RJHFRS/Matrix-project/Documentation/Matrix Routing PCBV3.png

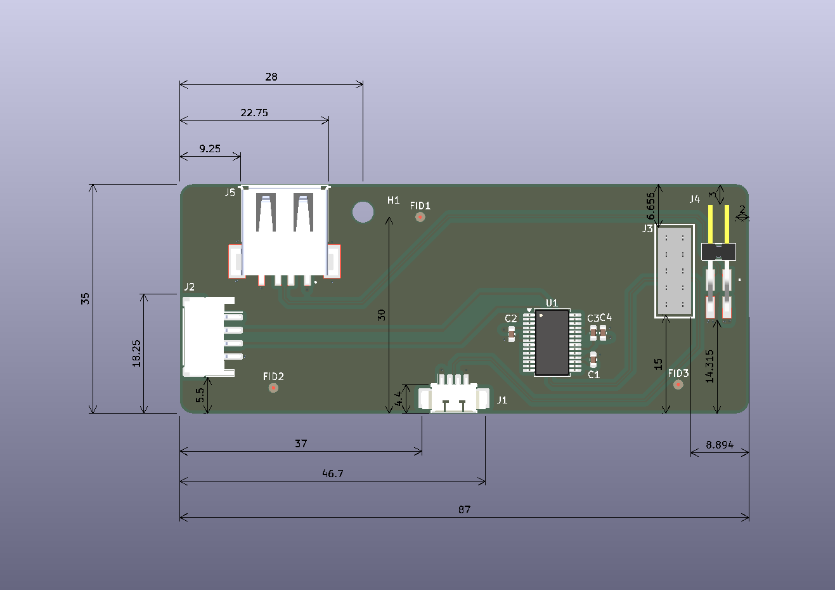
Documentation/Matrix Routing PCBV3.png
