RJHFRS/Matrix-project/Documentation/Matrix Routing PCB.png

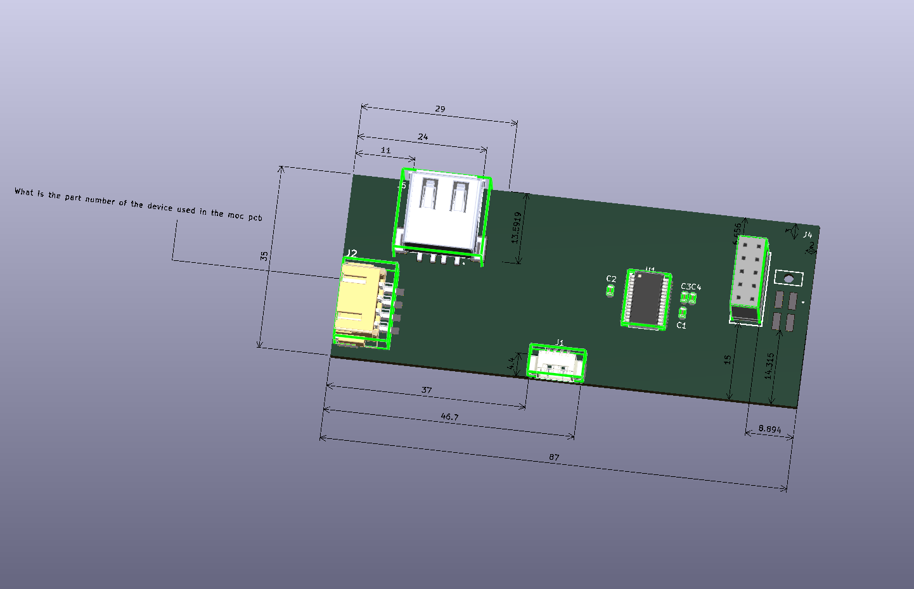
Documentation/Matrix Routing PCB.png
