RJHFRS/Matrix-project/Manufacturing/ASSEMBLY/MatrixMainBoard-Bom-OSpcb.ods

Designator | MPN | Qty | Description
C1, C3 | C0603C104K4RACTU | 2 | 0.1 µF ±10% 16V Ceramic Capacitor X7R 0603 (1608 Metric)
C2 | C0603C103K5RACTU | 1 | 10000 pF ±10% 50V Ceramic Capacitor X7R 0603 (1608 Metric)
C4 | GRM188C71C475KE21D | 1 | 4.7 µF ±10% 16V Ceramic Capacitor X7S 0603 (1608 Metric)
J1 | 53261-0471 | 1 | Connector Header Surface Mount, Right Angle 4 position 0.049" (1.25mm)
J2 | S4B-PH-SM4-TB | 1 | Connector Header Surface Mount, Right Angle 4 position 0.079" (2.00mm)
J3 | ESQ-105-23-T-D | 1 | 10 Position Elevated Socket Connector 0.100" (2.54mm) Through Hole Tin
J4 | TSM-102-01-L-DH-A | 1 | Connector Header Surface Mount, Right Angle 4 position 0.100" (2.54mm)
J5 | USB-A-S-F-B-SM2-R-TR | 1 | USB-A (USB TYPE-A) USB 2.0 Receptacle Connector 4 Position Surface Mount, Right Angle; Through Hole
U1 | FT232RL | 1 | IC USB FS SERIAL UART 28-SSOP
