RJHFRS/Matrix-project/Documentation/FullAssambly.FCStd

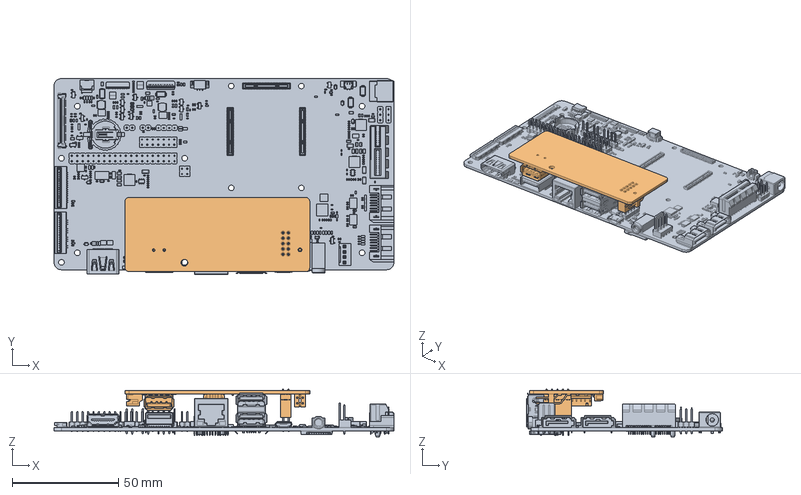
[picture p3: CAD file, 2026-09-24]
Documentation/FullAssambly.FCStd
160.0 x 92.2 x 22.6 mm
radxa_cm3_io_board_v1360_3d
Matrix Routing PCB_V3
