RJHFRS/Matrix-project/Documentation/FullAssamblyV2.FCStd

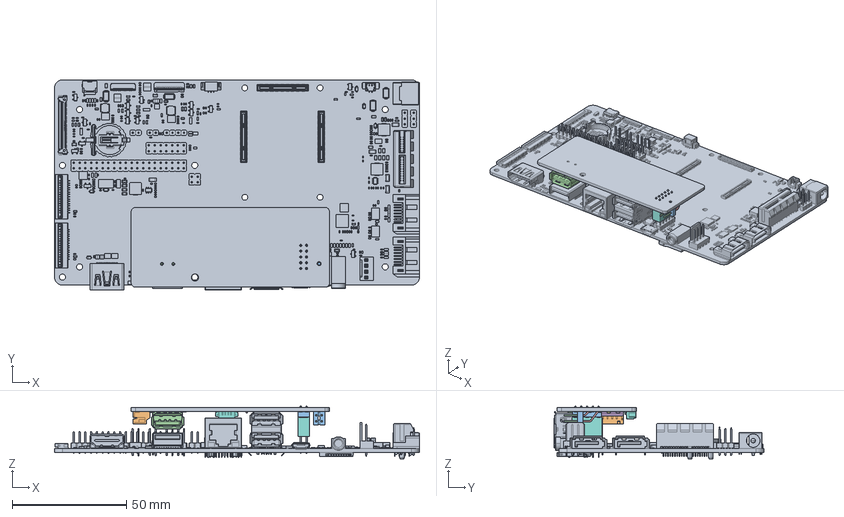
[picture p4: CAD file, 2026-09-24]
Documentation/FullAssamblyV2.FCStd
160.0 x 92.2 x 23.2 mm
Pcb_ed3
S4B-PH-SM4-TB part
TSM-102-01-DH-A_body
T-1S6-09-L(-01-2-DH)
T-1S6-09-L(-01-2-DH)2
C1_C_0603_1608Metric_a031bac950d4
C4_C_0603_1608Metric_6f453edf9163
ESQ-105-12-T-D_socket
ESQ-105-12-T-D_pins
ESQ-105-12-T-D2_pins
ESQ-105-12-G-D-LL_bpins
J5_USB-A-S-F-B-SM2-R-TR_759aa52d7a79
C2_C_0603_1608Metric_bcd04d63f79d
U1_SSOP-28_5.3x10.2mm_P0.65mm_af1eaf93d4b7
C3_C_0603_1608Metric_4dd471cfb941
J1_Molex_53261_0471_acc3970658d8
radxa_cm3_io_board_v1360_3d
