RJHFRS/Matrix-project/Documentation/Matrix Routing PCB_V3.step

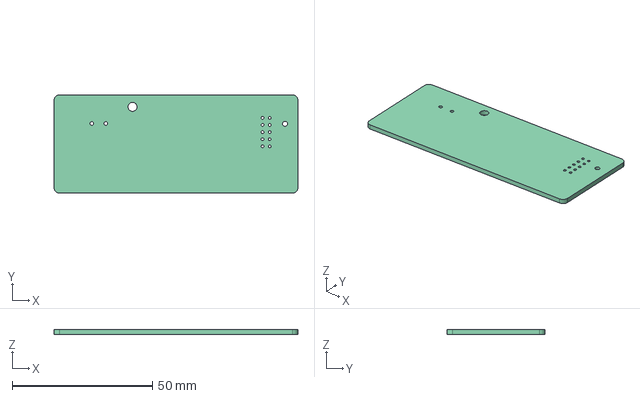
[picture p5: CAD file, 2026-09-24]
Documentation/Matrix Routing PCB_V3.step
87.0 x 35.0 x 1.66 mm
