RJHFRS/Matrix-project/MCAD/Matrix Routing PCBV8.FCStd

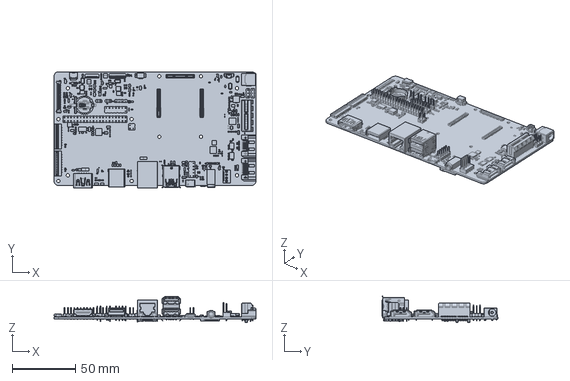
[picture p6: CAD file, 2026-10-01]
MCAD/Matrix Routing PCBV8.FCStd
160.0 x 92.2 x 20.8 mm
