RJHFRS/Matrix-project/MCAD/Matrix Routing PCBV7.FCStd

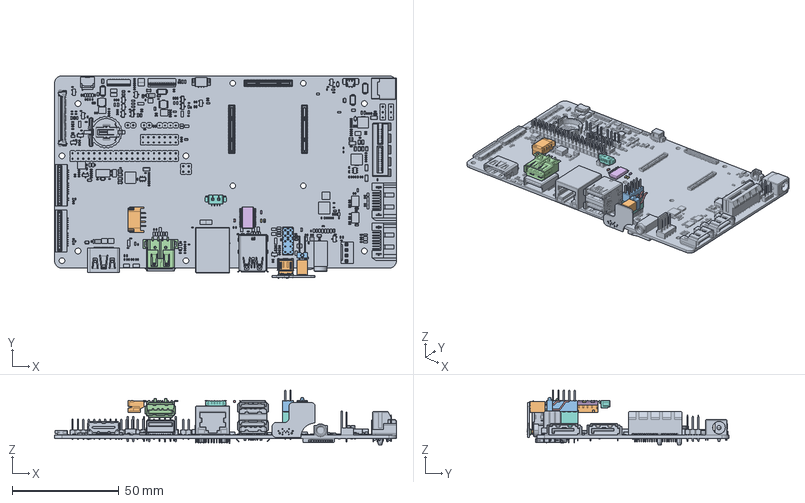
[picture p8: CAD file, 2026-09-28]
MCAD/Matrix Routing PCBV7.FCStd
160.0 x 94.7 x 25.5 mm
radxa_cm3_io_board_v1360_3d
S4B-PH-SM4-TB part
TSM-102-01-DH-A_body
T-1S6-09-L(-01-2-DH)
T-1S6-09-L(-01-2-DH)2
C1_C_0603_1608Metric_a031bac950d4
C4_C_0603_1608Metric_6f453edf9163
ESQ-105-23-T-D_socket
ESQ-105-23-T-D_pins
ESQ-105-23-T-D2_pins
ESQ-105-23-G-D-LL_bpins
J5_USB-A-S-F-B-SM2-R-TR_759aa52d7a79
C2_C_0603_1608Metric_bcd04d63f79d
U1_SSOP-28_5.3x10.2mm_P0.65mm_af1eaf93d4b7
C3_C_0603_1608Metric_4dd471cfb941
J1_Molex_53261_0471_acc3970658d8
Pcb_f5fe
SSM-102-L-DV_body
C-137-01-L2
HOUSING
CONTACT
CONTACT-1
CONTACT stack=1.3mm
PRT0004
PRT0005
PRT0006
