RJHFRS/Matrix-project/PCB project/3Dmodels/ESQ-105-33-T-D.stp

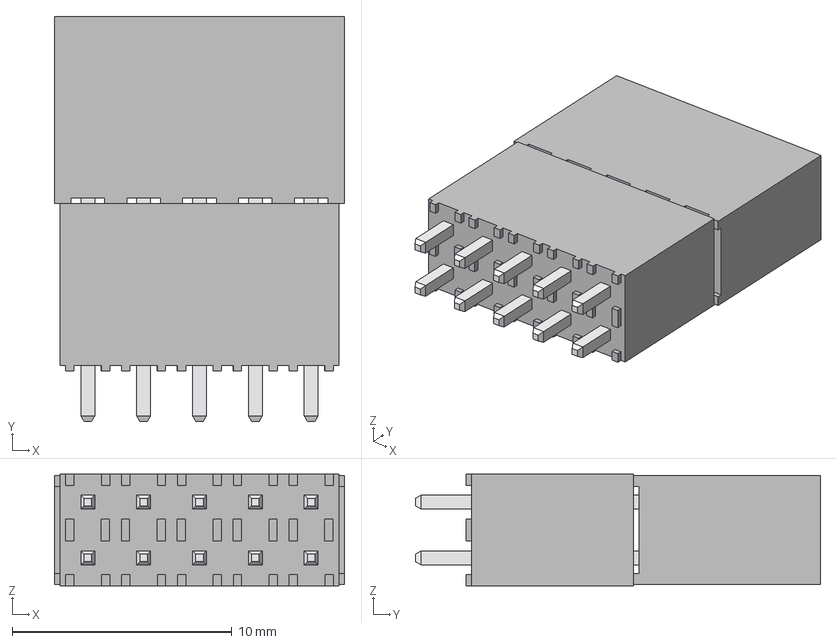
[picture p9: CAD file, 2026-09-24]
PCB project/3Dmodels/ESQ-105-33-T-D.stp
13.2 x 18.4 x 5.08 mm
ESQ-105-33-T-D_socket
ESQ-105-33-T-D_pins
ESQ-105-33-T-D2_pins
ESQ-105-33-G-D-LL_bpins
