RJHFRS/Matrix-project/PCB project/3Dmodels/S4B-PH-SM4-TB -LF--SN---3DModel-STEP-56544.STEP

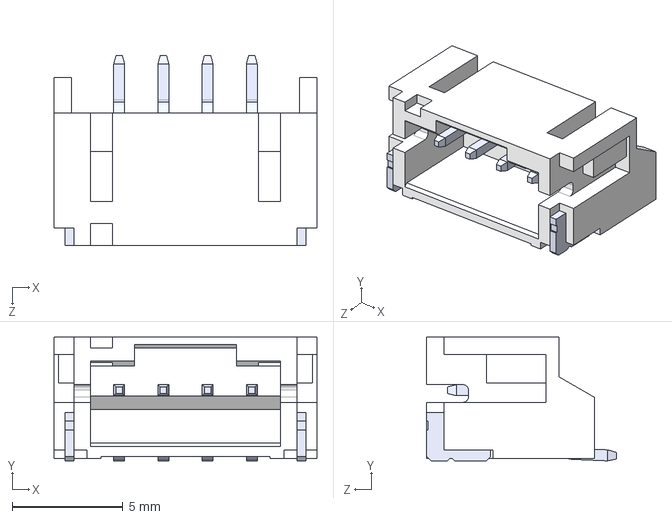
[picture p12: CAD file, 2026-09-22]
PCB project/3Dmodels/S4B-PH-SM4-TB -LF--SN---3DModel-STEP-56544.STEP
11.9 x 5.60 x 8.60 mm
