RJHFRS/Matrix-project/PCB project/3Dmodels/TSM-102-01-L-DH-A.stp

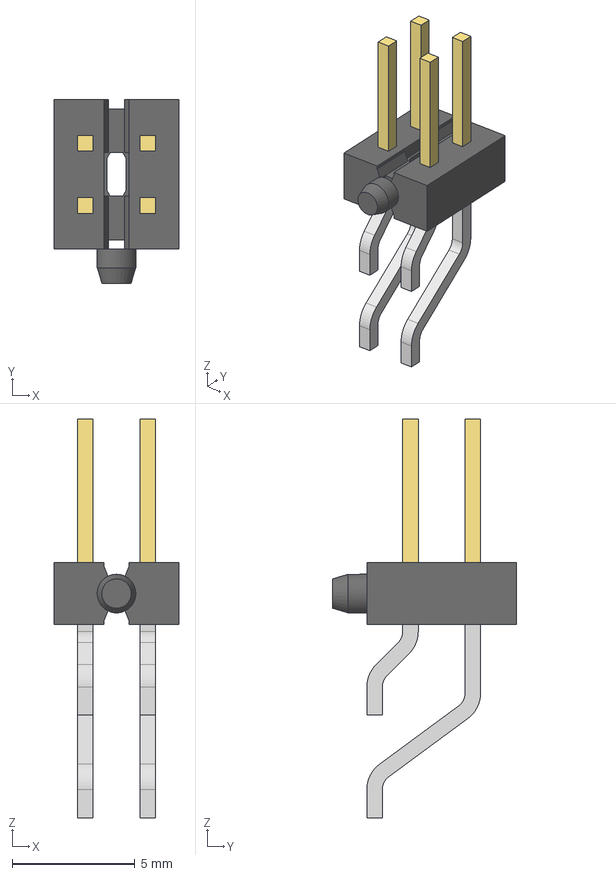
[picture p13: CAD file, 2026-09-22]
PCB project/3Dmodels/TSM-102-01-L-DH-A.stp
5.08 x 7.49 x 16.3 mm
TSM-102-01-DH-A_body
T-1S6-09-L(-01-2-DH)
T-1S6-09-L(-01-2-DH)2
