RJHFRS/Matrix-project/PCB project/3Dmodels/ESQ-105-12-T-D.stp

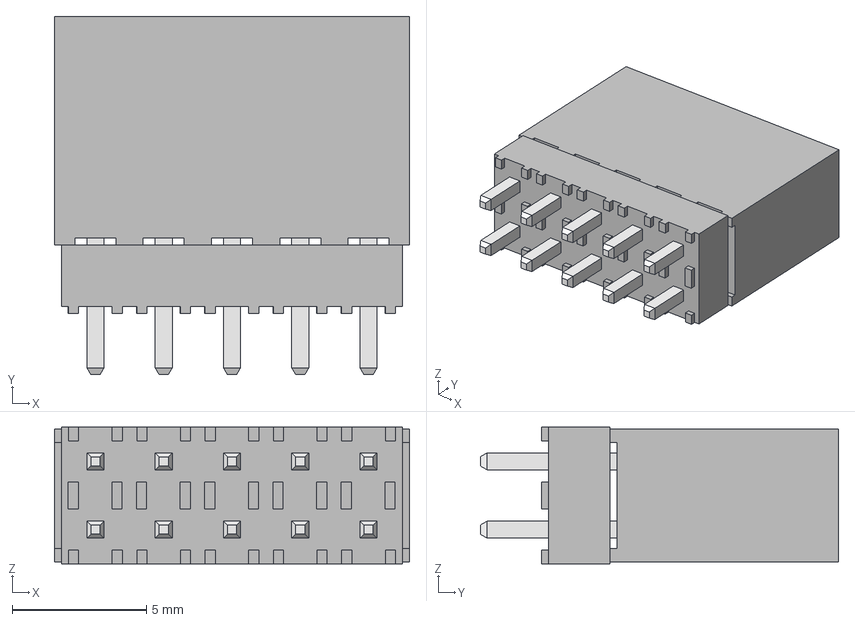
[picture p14: CAD file, 2026-09-22]
PCB project/3Dmodels/ESQ-105-12-T-D.stp
13.2 x 13.3 x 5.08 mm
ESQ-105-12-T-D_socket
ESQ-105-12-T-D_pins
ESQ-105-12-T-D2_pins
ESQ-105-12-G-D-LL_bpins
