RJHFRS/Matrix-project/PCB project/3Dmodels/USB-A-S-F-B-SM2-R-TR0.step

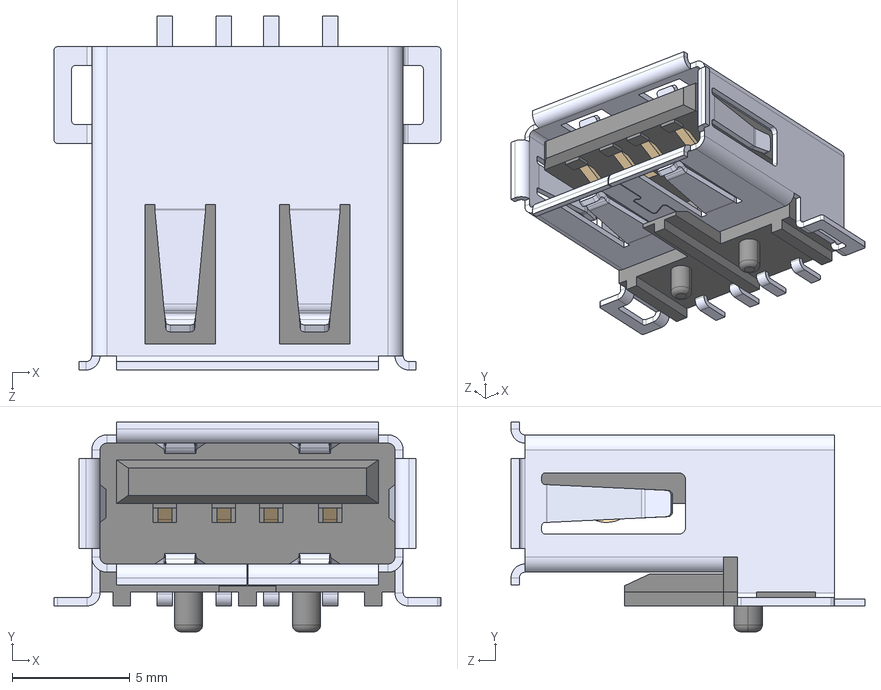
[picture p15: CAD file, 2026-09-22]
PCB project/3Dmodels/USB-A-S-F-B-SM2-R-TR0.step
16.4 x 8.89 x 15.0 mm
