RJHFRS/Matrix-project/PCB project/3Dmodels/S4B-XH-SM4-TB_LF__SN_.stp

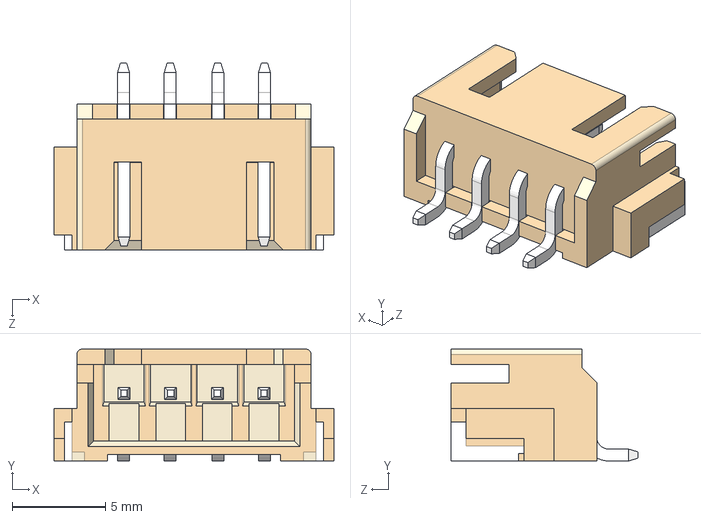
[picture p16: CAD file, 2026-09-22]
PCB project/3Dmodels/S4B-XH-SM4-TB_LF__SN_.stp
15.0 x 6.00 x 10.0 mm
