RJHFRS/Matrix-project/PCB project/3Dmodels/5326104710.step

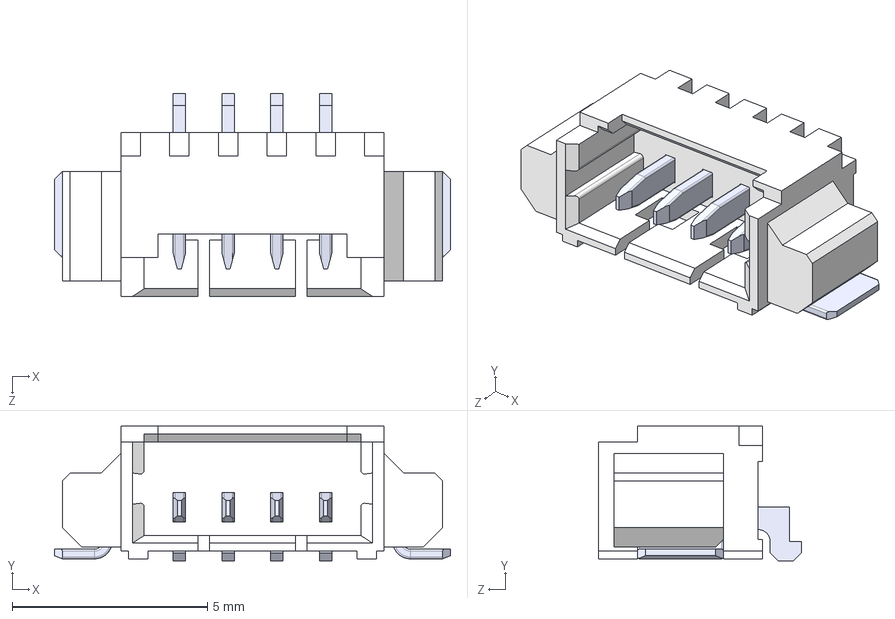
[picture p17: CAD file, 2026-09-22]
PCB project/3Dmodels/5326104710.step
10.2 x 3.45 x 5.20 mm
