RJHFRS/Matrix-project/(list of files, cad)

Other CAD files:
MCAD/Matrix USB OTG.FCStd
MCAD/Matrix.FCStd
PCB project/3Dmodels/S4B-PH-SM4-TB0.step
