RJHFRS/Matrix-project/PCB project/Matrix Routing PCB.kicad_pcb

## KiCad design PCB project/Matrix Routing PCB.kicad_pcb (2026-09-28)

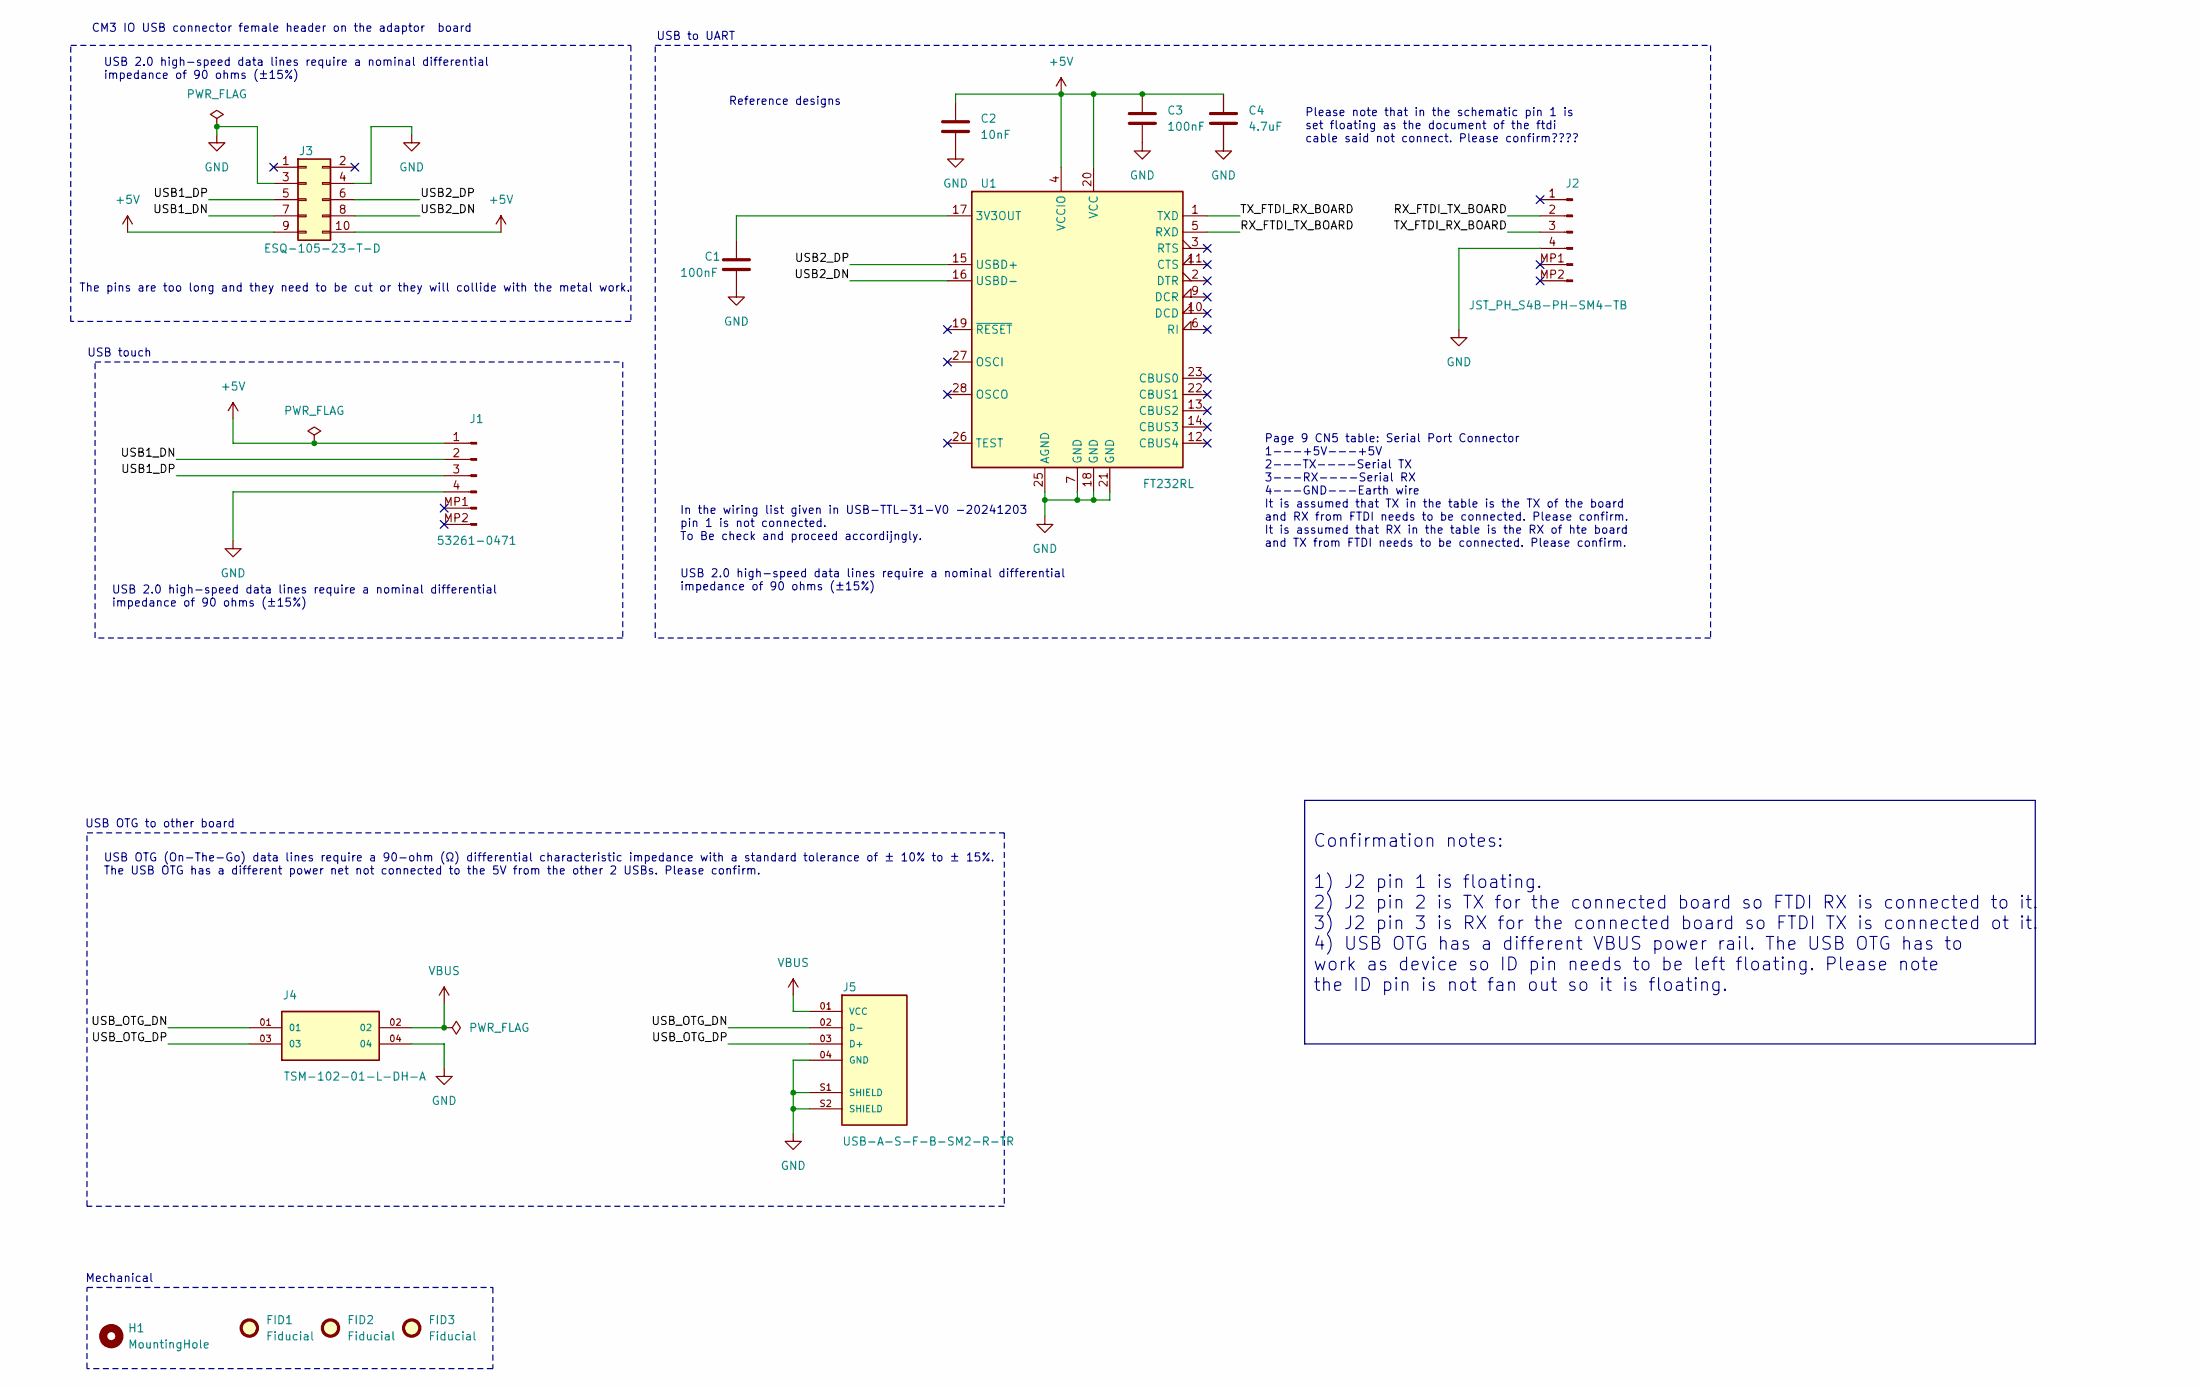
[picture p18: schematic Matrix Routing PCB.kicad_sch, Matrix]

Parts:
C1, C3: 100nF; C_0603_1608Metric; MPN C0603C104K4RACTU; Digikey PN 399-C0603C104K4RACTUCT-ND
C2: 10nF; C_0603_1608Metric; MPN C0603C103K5RACTU; Digikey PN 399-C0603C103K5RACTUCT-ND
C4: 4.7uF; C_0603_1608Metric; MPN GRM188C71C475KE21D; Digikey PN 490-16337-1-ND
FID1, FID2, FID3: Fiducial; Fiducial_0.5mm_Mask1.5mm
H1: MountingHole; MountingHole_3.2mm_M3
J1: 53261-0471; Molex_PicoBlade_53261-0471_1x04-1MP_P1.25mm_Horizontal; MPN 53261-0471; Digikey PN WM7622CT-ND
J2: JST_PH_S4B-PH-SM4-TB; JST_PH_S4B-PH-SM4-TB_1x04-1MP_P2.00mm_Horizontal; MPN S4B-PH-SM4-TB; Digikey PN 455-S4B-PH-SM4-TBCT-ND
J3: ESQ-105-23-T-D; ESQ-105-XX-X-D; MPN ESQ-105-33-T-D; Digikey PN ESQ-105-23-T-D-ND
J4: TSM-102-01-L-DH-A; SAMTEC_TSM-102-01-L-DH-A; PARTREV R; Digikey PN SAM15344-ND
J5: USB-A-S-F-B-SM2-R-TR; SAMTEC_USB-A-S-X-X-SM2-R; PARTREV T; Digikey PN 612-USB-A-S-F-B-SM2-R-TRCT-ND
U1: FT232RL; SSOP-28_5.3x10.2mm_P0.65mm; MPN FT232RL; Digikey PN 768-1306-ND

Connections:
+5V: C2.1, C3.1, C4.1, J1.1, J3.9, J3.10, U1.4 (VCCIO), U1.20 (VCC)
/RX_FTDI_TX_BOARD: J2.2, U1.5 (RXD)
/TX_FTDI_RX_BOARD: J2.3, U1.1 (TXD)
/USB1_DN: J1.2, J3.7
/USB1_DP: J1.3, J3.5
/USB2_DN: J3.8, U1.16 (USBD-)
/USB2_DP: J3.6, U1.15 (USBD+)
/USB_OTG_DN: J4.01, J5.02 (D-)
/USB_OTG_DP: J4.03, J5.03 (D+)
GND: C1.2, C2.2, C3.2, C4.2, J1.4, J2.4, J3.3, J3.4, J4.04, J5.04 (GND), J5.S1 (SHIELD), J5.S2 (SHIELD), U1.7 (GND), U1.18 (GND), U1.21 (GND), U1.25 (AGND)
unnamed: C1.1, U1.17 (3V3OUT)
VBUS: J4.02, J5.01 (VCC)

Notes on the sheet:
USB OTG to other board
USB to UART
The pins are too long and they need to be cut or they will collide with the metal work.
Reference designs
Confirmation notes: 1) J2 pin 1 is floating. 2) J2 pin 2 is TX for the connected board so FTDI RX is connected to it. 3) J2 pin 3 is RX for the connected board so FTDI TX is connected ot it. 4) USB OTG has a different VBUS power rail. The USB OTG has to work as device so ID pin needs to be left flo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
USB touch
Page 9 CN5 table: Serial Port Connector 1---+5V---+5V 2---TX----Serial TX 3---RX----Serial RX 4---GND---Earth wire It is assumed that TX in the table is the TX of the board and RX from FTDI needs to be connected. Please confirm. It is assumed that RX in the table is the RX of hte board and TX from 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
In the wiring list given in USB-TTL-31-V0 -20241203 pin 1 is not connected. To Be check and proceed accordijngly.
CM3 IO USB connector female header on the adaptor board
USB 2.0 high-speed data lines require a nominal differential impedance of 90 ohms (±15%)
Mechanical
Please note that in the schematic pin 1 is set floating as the document of the ftdi cable said not connect. Please confirm????
USB OTG (On-The-Go) data lines require a 90-ohm (Ω) differential characteristic impedance with a standard tolerance of ± 10% to ± 15%. The USB OTG has a different power net not connected to the 5V from the other 2 USBs. Please confirm.

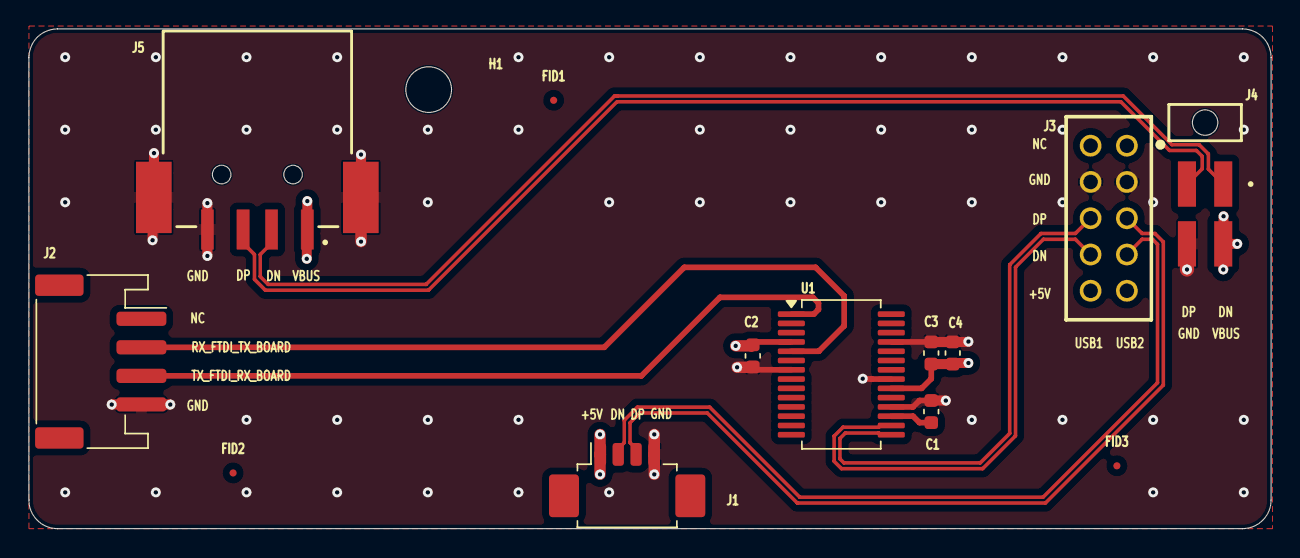
[picture p19: board Matrix Routing PCB.kicad_pcb from above]

Board: 4 copper layers, 87.0 x 35.0 mm, 14 parts (0 on the bottom side), 12 nets.
