RJHFRS/Matrix-project/(commit log)

2026-09-19 First commit fo all the kicad files
    [Matrix Routing PCB.kicad_pcb, Matrix Routing PCB.kicad_sch]
2026-09-21 All connectors are added to the schematic with the libraries
    [Matrix Routing PCB.kicad_pcb, Matrix Routing PCB.kicad_sch]
2026-09-21 Schematic finish
    [Matrix Routing PCB.kicad_pcb, Matrix Routing PCB.kicad_sch]
2026-09-21 House keeping changes
    [Matrix Routing PCB.kicad_pcb, Matrix Routing PCB.kicad_sch]
2026-09-21 Add schematic print for review
2026-09-21 Again push the schematic
2026-09-22 Add the confirmation notes
    [Matrix Routing PCB.kicad_sch]
2026-09-22 Placement to review
    [5326104710.step, ESQ-105-23-T-D.stp, Matrix Routing PCB.kicad_pcb, Matrix Routing PCB.kicad_sch, S4B-PH-SM4-TB0.step, S4B-XH-SM4-TB_LF__SN_.stp, USB-A-S-F-B-SM2-R-TR0.step]
2026-09-22 Placement is done and 3D generated
    [ESQ-105-12-T-D.stp, Matrix Routing PCB.kicad_pcb, Matrix Routing PCB.kicad_sch, S4B-PH-SM4-TB -LF--SN---3DModel-STEP-56544.STEP, TSM-102-01-L-DH-A.stp]
2026-09-22 Clear J5 second hole
    [Matrix Routing PCB.kicad_pcb, Matrix Routing PCB.step]
2026-09-22 Make J2 and J5 part of the project library
    [Matrix Routing PCB.kicad_pcb, Matrix Routing PCB.kicad_sch]
2026-09-23 Adding the netclasses, and physical board and track and gap
    [Matrix Routing PCB.kicad_pcb, Matrix Routing PCB.kicad_sch]
2026-09-23 Routing, no DRC errors just warnings
    [Matrix Routing PCB.kicad_pcb]
2026-09-23 V1 prepare for generating the manufacturing files
    [Matrix Routing PCB.csv, Matrix Routing PCB.kicad_pcb, Matrix Routing PCB.kicad_sch, Matrix Routing PCB_V1.step]
2026-09-23 Fix 3D conflicts
    [.step, Matrix Routing PCB.kicad_pcb, Matrix Routing PCBV2.step, Matrix.FCStd]
2026-09-23 Fix J5 potition
    [Matrix Routing PCB.kicad_pcb, Matrix Routing PCB_V3.step]
2026-09-23 Version for Review, long connector is too short
    [Matrix Routing PCB.kicad_pcb, Matrix.FCStd]
2026-09-24 Commit after review
    [.step, ESQ-105-34-T-D.stp, FullAssambly.FCStd, FullAssamblyV2.FCStd, Matrix Routing PCB.kicad_pcb, Matrix Routing PCB.kicad_sch, Matrix Routing PCB.ods, Matrix Routing PCBV2.step]
2026-09-24 Reemplace connetor to ESq-105-33-T-D
    [ESQ-105-33-T-D.stp, Matrix Routing PCB.csv, Matrix Routing PCB.kicad_pcb, Matrix Routing PCB.ods, Matrix Routing PCBV3.FCStd]
2026-09-24 Move the USB otg connector 2.7mm forward
    [Matrix Routing PCB.kicad_pcb, Matrix Routing PCBV3.FCStd, Matrix USB OTG.FCStd]
2026-09-25 Change the ESQ-105-33-T-D to ESQ-105-23-T-D
    [FinalAssamblyV1.FCStd, Matrix Routing PCB.kicad_pcb, Matrix Routing PCB.kicad_sch, Matrix Routing PCB.ods, Matrix Routing PCBV3.FCStd, Matrix Routing PCBV4.FCStd, Matrix Routing PCBV5.FCStd]
2026-09-25 Change 3D model from samtec ESQ-105-23-T-D
    [ESQ-105-23-T-D.stp, Matrix Routing PCB.kicad_pcb, Matrix Routing PCBV6.FCStd]
2026-09-25 Move J2 2.41mm forward
    [Matrix Routing PCB.kicad_pcb, Matrix Routing PCBV6.FCStd]
2026-09-25 Move J2 1.27mm back
    [Matrix Routing PCB.kicad_pcb, Matrix Routing PCBV6.FCStd]
2026-09-25 Final model
    [FinalAssamblyV1.FCStd, Matrix Routing PCBV3.FCStd, Matrix Routing PCBV4.FCStd, Matrix Routing PCBV5.FCStd, Matrix Routing PCBV6.FCStd]
2026-09-28 Add stitching vias
    [Matrix Routing PCB.kicad_pcb, Matrix Routing PCBV7.FCStd]
2026-09-28 Manufacturing FAB rev1
    [BomExample-OSpcb.xlsx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]
2026-09-28 Add silkscreen to for test documentation
    [BomExample-OSpcb.ods, BomExample-OSpcb.xlsx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]
2026-10-01 Make the libraries local to the project
    [Matrix Routing PCBV8.FCStd, MatrixMainBoard-Bom-OSpcb.ods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]
