RJHFRS/Matrix-project/(notices)

Notices in the files:
PCB project/3Dmodels/ESQ-105-33-T-D.stp:
author */ ('License CC BY-ND 4.0'),
